Zlxwy/GraduationProject/README.md

- [Code\_MasterController](#code_mastercontroller)
- [Code\_SlaveController](#code_slavecontroller)
- [Code\_SomeTools](#code_sometools)
- [Code\_TestCode](#code_testcode)
- [Doc\_DesignData](#doc_designdata)
- [Model\_ChineseChess](#model_chinesechess)
- [PCB\_BaseBoard](#pcb_baseboard)

## Code_MasterController

上位机 RDK X5 的程序。

## Code_SlaveController

下位机 STM32F407ZGT6 的程序。

## Code_SomeTools

编写的一些辅助开发使用的小工具。

## Code_TestCode
一些测试代码，如程序功能验证、硬件完好性测试等。

## Doc_DesignData

设计资料、文档。

## Model_ChineseChess

中国象棋的 3D 模型

## PCB_BaseBoard

使用嘉立创 EDA 绘制的底板 PCB 文件。
