Zlxwy/GraduationProject/Doc_DesignData/004_通信协议.md

* [协议简介](#协议简介)
* [协议内容](#协议内容)
  * [步进电机基础行走请求](#步进电机基础行走请求)
  * [机械臂XY平面行走请求](#机械臂XY平面行走请求)
  * [竖轴位置请求](#竖轴位置请求)
  * [磁铁使能请求](#磁铁使能请求)
  * [机械臂标定完成应答](#机械臂标定完成应答)
  * [按键Click事件](#按键Click事件)

# 协议简介

1. 双帧头发送
    - (FrameHeader) 第1个字节固定为0x53
    - (FrameType) 第2个字节则根据请求帧、应答帧、事件帧的不同而不同
        - (RequestFrame) 请求帧：0xCA
        - (ResponseFrame) 应答帧：0x35
        - (EventFrame) 事件帧：0x96
2. (PayloadSize) 然后就是4个字节，表示数据长度，为大端字节序
3. (PayloadData) 然后就是主要数据部分，其长度为上一步中指定的长度
    - (CommandType) 数据部分的前2个字节用来表示指令类型
4. (CRC16) 最后就是2个字节的CRC16校验，也为大端字节序

# 协议内容

> 以下示例命令的CommandType和校验码都不准确

## ✔ 步进电机基础行走请求

```
描述：指定步进电机，以指定速度，行走指定步数
帧类型：请求帧，上至下
CommandType固定为0x00 0x00
```

| PayloadData 包含字段 | 字节偏移 | 长度(Byte) | 序列类型 | 说明 |
| --- | --- | --- | --- | --- |
| CommandType | 0 | 2 | uint16，大端序 | 固定为0x00 0x00 |
| MotorID | 2 | 1 | uint8，单字节 | 标识步进电机：<ul><li>0x00 - 肩关节电机</li><li>0x01 - 肘关节电机</li><li>0x02 - 竖轴电机</li></ul> |
| ActionType | 3 | 1 | uint8，单字节 | 动作类型：<ul><li>0x00 - 停止</li><li>0x01：旋转指定步数</li><li>0x02 - 持续旋转（Steps为-1则反转，Steps为1则正转）</li></ul> |
| Steps | 4 | 8 | int64，大端序 | 指定行走步数 |
| Speed | 12 | 4 | uint32，大端序 | 指定行走速度 |

| FrameHeader | FrameType | PayloadSize | CommandType | MotorID | ActionType | Steps | Speed | CRC16 |
| --- | --- | --- | --- | --- | --- | --- | --- | --- |
| 53 | CA | 00 00 00 10 | 00 00 | 00 | 01 | 00 00 00 00 00 00 00 C8 | 00 00 02 9A | xx xx |
| 帧头 | 帧类型：<br>请求帧 | 数据长度：<br>16字节 | 指令类型：<br>步进电机基础行走 | 电机ID：<br>0x00 | 动作类型：<br>旋转指定步数 | 步数：<br>0x00C8(200)步 | 速度：<br>0x029A(666)Hz | CRC16校验：<br>0x3687 |
| 53 | CA | 00 00 00 10 | 00 00 | 00 | 01 | 00 00 00 00 00 00 01 90 | 00 00 06 13 | xx xx |
| 帧头 | 帧类型：<br>请求帧 | 数据长度：<br>16字节 | 指令类型：<br>步进电机基础行走 | 电机ID：<br>0x00 | 动作类型：<br>旋转指定步数 | 步数：<br>0x0190(400)步 | 速度：<br>0x0613(1555)Hz | CRC16校验：<br>0xA85D |
| 53 | CA | 00 00 00 10 | 00 00 | 00 | 01 | FF FF FF FF FF FF FE 70 | 00 00 02 9A | xx xx |
| 帧头 | 帧类型：<br>请求帧 | 数据长度：<br>16字节 | 指令类型：<br>步进电机基础行走 | 电机ID：<br>0x00 | 动作类型：<br>旋转指定步数 | 步数：<br>0xFFFFFFFFFFFFFE70(-400)步 | 速度：<br>0x029A(666)Hz | CRC16校验：<br>0x5F75 |

## 机械臂XY平面行走请求

```
描述：控制机械臂在XY平面上行走到指定坐标点
帧类型：请求帧，上至下
CommandType固定为0x00 0x01
```

| PayloadData 包含字段 | 字节偏移 | 长度(Byte) | 序列类型 | 说明 |
| --- | --- | --- | --- | --- |
| CommandType | 0 | 2 | uint16，大端序 | 固定为0x00 0x01 |
| PixelCoordX | 2 | 4 | float，大端序 | 指定X轴坐标点，单位为像素 |
| PixelCoordY | 6 | 4 | float，大端序 | 指定Y轴坐标点，单位为像素 |
| Side | 10 | 1 | bool，单字节 | 机械臂关节向哪边拐：<ul><li>0x00 - 左拐</li><li>else - 右拐</li></ul> |

| FrameHeader | FrameType | PayloadSize | CommandType | PixelCoordX | PixelCoordY | Side | CRC16 |
| --- | --- | --- | --- | --- | --- | --- | --- |
| 53 | CA | 00 00 00 0B | 00 03 | 42 61 49 BA | 44 83 48 00 | 00 | 58 5F |
| 帧头 | 帧类型：<br>请求帧 | 数据长度：<br>11字节 | 指令类型：<br>机械臂X-Y平面行走 | X轴坐标点：<br>0x426149BA(56.322)像素 | Y轴坐标点：<br>0x44834800(1050.25)像素 | 左拐 | CRC16校验：<br>0x585F |
| 53 | CA | 00 00 00 0B | 00 03 | 3F 99 99 9A | 41 2E 3D 71 | 01 | 62 90 |
| 帧头 | 帧类型：<br>请求帧 | 数据长度：<br>11字节 | 指令类型：<br>机械臂X-Y平面行走 | X轴坐标点：<br>0x3F99999A(1.2)像素 | Y轴坐标点：<br>0x412E3D71(10.89)像素 | 右拐 | CRC16校验：<br>0x6290 |
| 53 | CA | 00 00 00 0B | 00 03 | 44 04 60 00 | 44 5E 33 33 | 61 | 6A 78 |
| 帧头 | 帧类型：<br>请求帧 | 数据长度：<br>11字节 | 指令类型：<br>机械臂X-Y平面行走 | X轴坐标点：<br>0x44046000(529.5)像素 | Y轴坐标点：<br>0x445E3333(888.8)像素 | 右拐 | CRC16校验：<br>0x6A78 |

## ✔ 竖轴复位请求

```
描述：控制机械臂Z轴复位到限位器处
帧类型：请求帧，上至下
CommandType固定为0x00 0x02
```

| PayloadData 包含字段 | 字节偏移 | 长度(Byte) | 序列类型 | 说明 |
| --- | --- | --- | --- | --- |
| CommandType | 0 | 2 | uint16，大端序 | 固定为0x00 0x02 |

| FrameHeader | FrameType | PayloadSize | CommandType | CRC16 |
| --- | --- | --- | --- | --- |

## ✔ 竖轴位置请求

```
描述：控制机械臂Z轴下降位置
帧类型：请求帧，上至下
CommandType固定为0x00 0x02
```

| PayloadData 包含字段 | 字节偏移 | 长度(Byte) | 序列类型 | 说明 |
| --- | --- | --- | --- | --- |
| CommandType | 0 | 2 | uint16，大端序 | 固定为0x00 0x02 |
| PositionZ | 2 | 4 | float，大端序 | 指定Z轴下降级数，范围0~100 |

| FrameHeader | FrameType | PayloadSize | CommandType | PositionZ | CRC16 |
| --- | --- | --- | --- | --- | --- |

## ✔ 设置磁铁状态

```
描述：设置磁铁状态
帧类型：请求帧，上至下
CommandType固定为0x00 0x05
```

| PayloadData 包含字段 | 字节偏移 | 长度(Byte) | 序列类型 | 说明 |
| --- | --- | --- | --- | --- |
| CommandType | 0 | 2 | uint16，大端序 | 固定为0x00 0x05 |
| MagnetStatus | 2 | 1 | uint8，单字节 | 磁铁状态：<ul><li>0x00 - 禁用</li><li>0x01 - 正向电压使能</li><li>0x02 - 反向电压使能</li></ul> |

> 示例指令：53 CA 00 00 00 03 00 03 00 6D B3
> 示例指令：53 CA 00 00 00 03 00 03 01 7D 92

## 机械臂标定完成应答

```
描述：在进入机械臂标定模式后，操作完成应答
帧类型：应答帧，上至下
CommandType固定为0x00 0x03
```

| PayloadData 包含字段 | 字节偏移 | 长度(Byte) | 序列类型 | 说明 |
| --- | --- | --- | --- | --- |
| CommandType | 0 | 2 | uint16，大端序 | 固定为0x00 0x03 |

| FrameHeader | FrameType | PayloadSize | CommandType | CRC16 |
| --- | --- | --- | --- | --- |
| 53 | 35 | 00 00 00 02 | 00 02 | 5C 27 |
| 帧头 | 帧类型：<br>应答帧 | 数据长度：<br>2字节 | 指令类型：<br>机械臂标定完成应答 | CRC16校验：<br>0x5C27 |

## ✔ 按键点击事件

```
描述：按键点击事件
帧类型：事件帧，下至上
CommandType固定为0x00 0x04
```

| PayloadData 包含字段 | 字节偏移 | 长度(Byte) | 序列类型 | 说明 |
| --- | --- | --- | --- | --- |
| CommandType | 0 | 2 | uint16，大端序 | 固定为0x00 0x04 |
| KeyIndex | 2 | 2 | uint16，大端序 | 按键索引：<ul><li>0x0000(Key0) - 显示/隐藏棋盘锚定框</li><li>0x0001(Key1) - 进入机械臂标定模式</li><li>0x0002(Key2) - 进入整理模式</li><li>0x0003(Key3) - 用户落子完成</li></ul> |
| KeyMotion | 4 | 1 | uint8_t | 按键动作：<ul><li>0x00 - 按键按下(Pressed)</li><li>0x01 - 按键释放(Released)</li></ul> |

| FrameHeader | FrameType | PayloadSize | CommandType | KeyIndex | KeyMotion | CRC16 |
| --- | --- | --- | --- | --- | --- | -- |
| 53 | 96 | 00 00 00 04 | 00 01 | 00 00 | 00 | BE 88 |
| 帧头 | 帧类型：<br>事件帧 | 数据长度：<br>4字节 | 指令类型：<br>按键点击事件 | 按键索引：<br>0x0000(Key0) - 显示/隐藏棋盘锚定框 | 按键动作：<br>按键按下 | CRC16校验：<br>0xBE88 |
| 53 | 96 | 00 00 00 04 | 00 01 | 00 01 | 00 | AE A9 |
| 帧头 | 帧类型：<br>事件帧 | 数据长度：<br>4字节 | 指令类型：<br>按键点击事件 | 按键索引：<br>0x0001(Key1) - 进入机械臂标定模式 | 按键动作：<br>按键按下 | CRC16校验：<br>0xAEA9 |
| 53 | 96 | 00 00 00 04 | 00 01 | 00 02 | 01 | 9E CA |
| 帧头 | 帧类型：<br>事件帧 | 数据长度：<br>4字节 | 指令类型：<br>按键点击事件 | 按键索引：<br>0x0002(Key2) - 进入整理模式 | 按键动作：<br>按键释放 | CRC16校验：<br>0x9ECA |
