Zlxwy/GraduationProject/Doc_DesignData/002_制作器件.md

[TOC]

## PCB物料

| 平台 | 店铺 | 物件 | 数量 | 单价(元) | 总付款(元) | 链接 |
| --- | --- | --- | --- | --- | --- | --- |
| 淘宝 | 科讯达数码专配店 | 12V10A电源适配器 | 1 | 32.5 | 32.5 | https://item.taobao.com/item.htm?id=708135618778&skuId=5980676298476 |
| 淘宝 | telesky旗舰店 | LM2596S\_5V\_稳压模块 | 2 | 4.24 | 8.48 | https://detail.tmall.com/item.htm?id=41307963557&skuId=5352660439882 |
| 淘宝 | 深圳市优信电子科技有限公司 | XH2.54\_10P\_直针插座(10个装) | 1 | 1.1 | 1.1 | https://item.taobao.com/item.htm?id=522555535449&skuId=5777387544677 |
| 淘宝 | 深圳市优信电子科技有限公司 | XH2.54\_10P\_插头胶壳(10个装) | 1 | 0.55 | 0.55 | https://item.taobao.com/item.htm?id=522555535449&skuId=5777387544705 |
| 淘宝 | 深圳市优信电子科技有限公司 | XH2.54\_4P\_直针插座(10个装) | 1 | 0.44 | 0.44 | https://item.taobao.com/item.htm?id=522555535449&skuId=5777387544671 |
| 淘宝 | 深圳市优信电子科技有限公司 | XH2.54\_4P\_插头胶壳(10个装) | 1 | 0.22 | 0.22 | https://item.taobao.com/item.htm?id=522555535449&skuId=5777387544699 |
| 淘宝 | 深圳市优信电子科技有限公司 | XH2.54\_3P\_直针插座(10个装) | 1 | 0.33 | 0.33 | https://item.taobao.com/item.htm?id=522555535449&skuId=5777387544670 |
| 淘宝 | 深圳市优信电子科技有限公司 | XH2.54\_3P\_插头胶壳(10个装) | 1 | 0.16 | 0.16 | https://item.taobao.com/item.htm?id=522555535449&skuId=5777387544698 |
| 淘宝 | 深圳市优信电子科技有限公司 | XH2.54\_2P\_直针插座(10个装) | 1 | 0.22 | 0.22 | https://item.taobao.com/item.htm?id=522555535449&skuId=5777387544669 |
| 淘宝 | 深圳市优信电子科技有限公司 | XH2.54\_2P\_插头胶壳(10个装) | 1 | 0.11 | 0.11 | https://item.taobao.com/item.htm?id=522555535449&skuId=5777387544697 |
| 淘宝 | 深圳市优信电子科技有限公司 | π122U31电平隔离芯片 | 1 | 0.8 | 0.8 | https://item.taobao.com/item.htm?id=713359542163 |
| 淘宝 | 深圳市优信电子科技有限公司 | UWM-817C-S光耦合器芯片 | 4 | 0.13 | 0.52 | https://item.taobao.com/item.htm?id=654107995926 |
| 淘宝 | 深圳市优信电子科技有限公司 | M7通用二极管(10个装) | 1 | 0.88 | 0.88 | https://item.taobao.com/item.htm?id=545440281632 |
| 淘宝 | 深圳市优信电子科技有限公司 | 0805贴片电阻10kΩ(50个装) | 1 | 1.1 | 1.1 | https://item.taobao.com/item.htm?id=526088038633&skuId=5870421994599 |
| 淘宝 | 深圳市优信电子科技有限公司 | 0805贴片电阻4.7kΩ(50个装) | 1 | 1.1 | 1.1 | https://item.taobao.com/item.htm?id=526088038633&skuId=5870421994575 |
| 淘宝 | 深圳市优信电子科技有限公司 | 0805贴片LED黄色(10个装) | 1 | 2.2 | 2.2 | https://item.taobao.com/item.htm?id=570459797098&skuId=5935337974485 |
| 淘宝 | 深圳市优信电子科技有限公司 | 0805贴片LED翠绿色(10个装) | 1 | 2.75 | 2.75 | https://item.taobao.com/item.htm?id=570459797098&skuId=5935337974486 |
| 淘宝 | 深圳市优信电子科技有限公司 | 0805贴片LED蓝色(10个装) | 1 | 1.98 | 1.98 | https://item.taobao.com/item.htm?id=570459797098&skuId=5935337974484 |
| 淘宝 | 深圳市优信电子科技有限公司 | SS12D06G5\_3脚2档\_弯插拨动开关(5个装) | 1 | 2.64 | 2.64 | https://item.taobao.com/item.htm?id=568771505825&skuId=6130758858580 |
| 淘宝 | 深圳市优信电子科技有限公司 | DC005\_DC5525\_耐高温插座 | 1 | 0.2 | 0.2 | https://item.taobao.com/item.htm?id=556796729366&skuId=6130630902911 |
| 淘宝 | 深圳市宏宇通电子商行 | 2EDGK型接头\_2P开口式弯针插座+2P插头 | 1 | 0.24 | 0.24 | https://item.taobao.com/item.htm?id=589242587984&skuId=4021244136536 |

## 象棋制作物料

| 平台 | 店铺 | 物件 | 数量 | 单价(元) | 总付款(元) | 链接 |
| --- | --- | --- | --- | --- | --- | --- |
| 嘉立创 | 嘉立创3D打印 | 棋子模型\_材质LEDO白色\_粗磨(50件) | 1 | 96.29 | 96.29 | https://www.jlc-3dp.cn/placeOrder?spm=3D.Homepage.icon1.1001 |
| 淘宝 | 中钢金属物资 | 圆柱形铁饼\_直径18mm\_高6mm(64件) | 1 | 100 | 100 | https://shop596005788.taobao.com/ |
| 闲鱼 | 乐逸印务 | 棋子贴纸\_整张A3纸打印 | 1 | 35 | 35 | https://www.goofish.com/item?id=996490925570 |
| 淘宝 | 星星舟旗舰店 | 大号中国象棋棋盘 | 1 | 22.8 | 22.8 | https://detail.tmall.com/item.htm?id=853560984174&skuId=6202772638395 |

## 控制器

| 平台 | 店铺 | 物件 | 数量 | 单价(元) | 总付款(元) | 链接 |
| --- | --- | --- | --- | --- | --- | --- |
| 淘宝 | 轮趣科技 | Linux板卡\_RDKX5 | 1 | 0 | 0 | https://item.taobao.com/item.htm?id=676436236906&sku_properties=1627207%3A35383862860 |
| 淘宝 | 桔恩迪电子 | STM32F407ZGT6核心板 | 1 | 72.99 | 72.99 | https://item.taobao.com/item.htm?id=767987284614&skuId=5296354469371 |
| 淘宝 | 桔恩迪电子 | 3.2寸TFT显示屏 | 1 | 79.99 | 79.99 | https://item.taobao.com/item.htm?id=811245556140&skuId=5674466479002 |

## 运动

| 平台 | 店铺 | 物件 | 数量 | 单价(元) | 总付款(元) | 链接 |
| --- | --- | --- | --- | --- | --- | --- |
| 淘宝 | 亿星科技步进伺服控制系统厂家 | 42步进电机 | 2 | 24 | 48 | https://item.taobao.com/item.htm?id=45176939892&skuId=4820009917609 |
| 淘宝 | 亿星科技步进伺服控制系统厂家 | 28步进电机 | 1 | 40 | 40 | https://item.taobao.com/item.htm?id=770017789135&skuId=5478339413663 |
| 淘宝 | 亿星科技步进伺服控制系统厂家 | 步进电机驱动器TB6600 | 3 | 30 | 90 | https://item.taobao.com/item.htm?id=45257012832&skuId=4473671716068 |
| 淘宝 | 风顺散热风扇 | 12V散热扇 | 1 | 5.5 | 5.5 | https://item.taobao.com/item.htm?id=582585891952&skuId=3903184540519 |
| 淘宝 | 恒运电磁铁制造商 | 12V电磁铁 | 1 | 6.69 | 6.69 | https://item.taobao.com/item.htm?id=639903956109&skuId=4601479117245 |
| 淘宝 | 深圳权芯发电子网店 一站配套 | L298N芯片+H型散热片 | 1 | 3.6 | 3.6 | https://item.taobao.com/item.htm?id=650714392966&skuId=4713871520670 |
| 淘宝 | 东菱工控 | U型槽型光电开关 | 1 | 7 | 7 | https://item.taobao.com/item.htm?id=626384709746&skuId=4934038281099 |

## 视觉

| 平台 | 店铺 | 物件 | 数量 | 单价(元) | 总付款(元) | 链接 |
| --- | --- | --- | --- | --- | --- | --- |
| 淘宝 | 杰锐微通旗舰店 | USB摄像头\_1080P | 1 | 128 | 128 | https://detail.tmall.com/item.htm?id=658336439677&skuId=4747876349104 |
| 淘宝 | 杰锐微通旗舰店 | USB摄像头\_适配无畸变3.25mm焦距100度镜头 | 1 | 58 | 58 | https://detail.tmall.com/item.htm?id=667551614995&skuId=4984718463985 |

## 接线

| 平台 | 店铺 | 物件 | 数量 | 单价(元) | 总付款(元) | 链接 |
| --- | --- | --- | --- | --- | --- | --- |
| 淘宝 | 上海凯豪电线电缆 | 0.3平方毫米线材\_100m长度\_黑色 | 1 | 25.74 | 25.74 | https://item.taobao.com/item.htm?id=575478995725&skuId=3775114793012 |
| 淘宝 | elecall旗舰店 | E2508管型端子\_黑色(100个装) | 1 | 3.42 | 3.42 | https://detail.tmall.com/item.htm?id=523300941522&skuId=5145209079969 |
| 淘宝 | elecall旗舰店 | E2508管型端子\_红色(100个装) | 1 | 3.42 | 3.42 | https://detail.tmall.com/item.htm?id=523300941522&skuId=4931023561692 |
| 淘宝 | 晶凝峰芯达专卖店 | XH2.54\_插接簧片(100个装) | 2 | 3.53 | 7.06 | https://detail.tmall.com/item.htm?id=41586800103&skuId=4973828213488 |

## 通信

| 平台 | 店铺 | 物件 | 数量 | 单价(元) | 总付款(元) | 链接 |
| --- | --- | --- | --- | --- | --- | --- |
| 淘宝 | 橘易 | CH343\_USB串口模块 | 1 | 14.9 | 14.9 | https://item.taobao.com/item.htm?id=781272048581&skuId=5507569043535 |
| 淘宝 | 绿联数码旗舰店 | USB2.0延长线1m | 2 | 14.9 | 29.8 | https://detail.tmall.com/item.htm?id=38926165525&skuId=6186711490290 |
| 淘宝 | orico旗舰店 | USB一拖三拓展坞 | 1 | 29.9 | 29.9 | https://detail.tmall.com/item.htm?id=658654834040&skuId=5143148725455 |

## 框架

| 平台 | 店铺 | 物件 | 数量 | 单价(元) | 总付款(元) | 链接 |
| --- | --- | --- | --- | --- | --- | --- |
| 淘宝 | 深圳探木坊铝业 | 铝型材\_欧标2020L-1.5\_长度304mm\_1件 | 1 | 3.8 | 3.8 | https://item.taobao.com/item.htm?id=707146227727&skuId=5138065850308 |
| 淘宝 | 深圳探木坊铝业 | 铝型材\_欧标2020L-1.5\_长度315mm\_2件 | 1 | 7.87 | 7.87 | https://item.taobao.com/item.htm?id=707146227727&skuId=5138065850308 |
| 淘宝 | 深圳探木坊铝业 | 铝型材\_欧标2020L-1.5\_长度264mm\_2件 | 1 | 6.6 | 6.6 | https://item.taobao.com/item.htm?id=707146227727&skuId=5138065850308 |
| 淘宝 | 深圳探木坊铝业 | 铝型材\_欧标2020L-1.5\_长度79mm\_1件 | 1 | 0.99 | 0.99 | https://item.taobao.com/item.htm?id=707146227727&skuId=5138065850308 |
| 淘宝 | 深圳探木坊铝业 | 铝型材\_欧标2020L-1.5\_长度56mm\_2件 | 1 | 1.4 | 1.4 | https://item.taobao.com/item.htm?id=707146227727&skuId=5138065850308 |
| 淘宝 | 深圳探木坊铝业 | 铝型材\_欧标2020L-1.5\_长度132mm\_1件 | 1 | 1.65 | 1.65 | https://item.taobao.com/item.htm?id=707146227727&skuId=5138065850308 |
| 淘宝 | 深圳探木坊铝业 | 铝型材\_欧标2020L-1.5\_长度99mm\_2件 | 1 | 2.47 | 2.47 | https://item.taobao.com/item.htm?id=707146227727&skuId=5138065850308 |
| 淘宝 | 深圳探木坊铝业 | 铝型材\_欧标2020L-1.5\_长度100mm\_2件 | 1 | 2.5 | 2.5 | https://item.taobao.com/item.htm?id=707146227727&skuId=5138065850308 |
| 淘宝 | 深圳探木坊铝业 | 铝型材\_欧标2020L-1.5\_长度186mm\_1件 | 1 | 2.32 | 2.32 | https://item.taobao.com/item.htm?id=707146227727&skuId=5138065850308 |
| 淘宝 | 深圳探木坊铝业 | 铝型材\_欧标2020L-1.5\_长度450mm\_2件 | 1 | 11.25 | 11.25 | https://item.taobao.com/item.htm?id=707146227727&skuId=5138065850308 |
| 淘宝 | 深圳探木坊铝业 | 铝型材紧固件\_欧标2020L-1.5\_直角角码 | 28 | 0.9 | 25.2 | https://item.taobao.com/item.htm?id=687965688085&skuId=4907036397671 |
| 淘宝 | 深圳探木坊铝业 | 铝型材紧固件\_欧标2020L-1.5\_转向角件 | 3 | 1.56 | 4.68 | https://item.taobao.com/item.htm?id=694506337343&skuId=4932711441831 |
| 闲鱼 | 用户AdoRobot | 三轴平面机械臂3D打印模型 | 1 | 600 | 600 | https://www.goofish.com/personal?userId=696934590 |

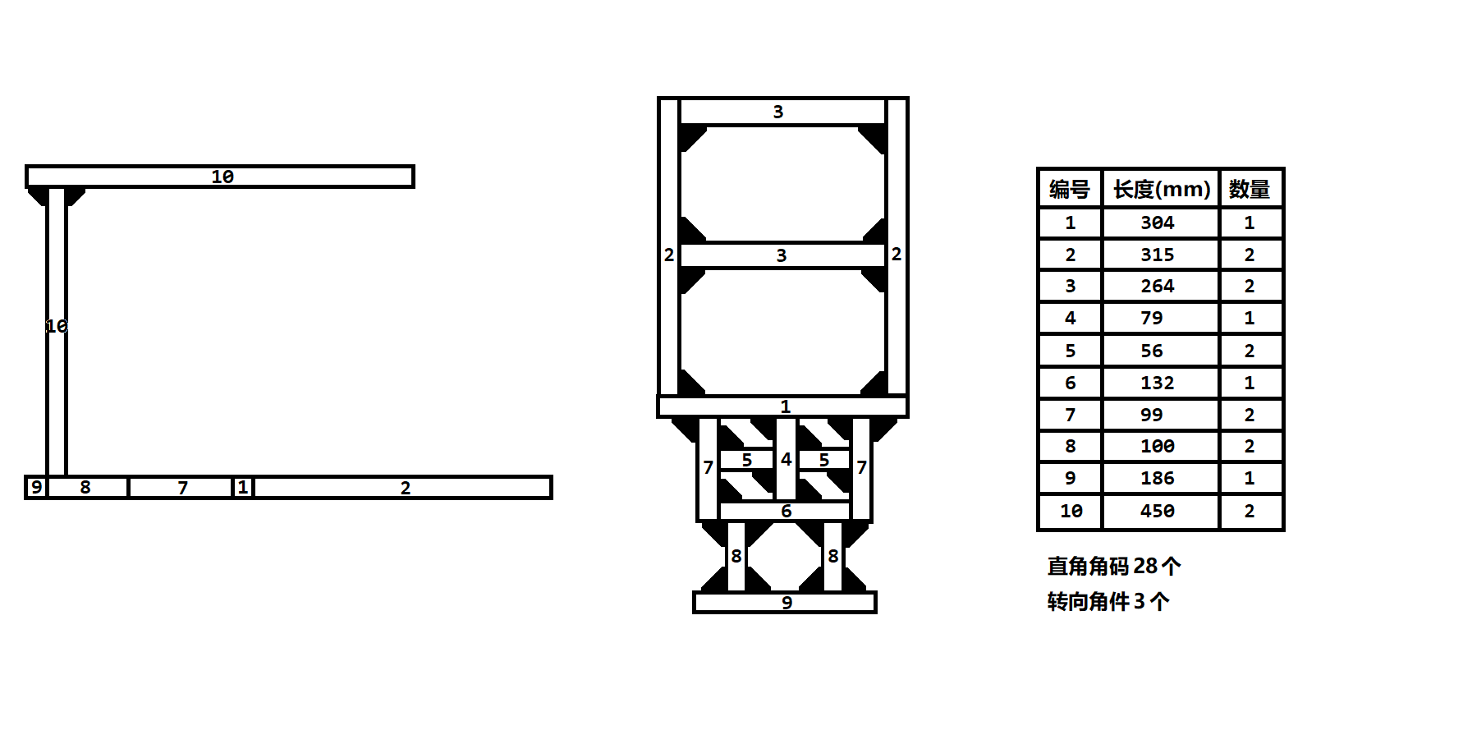
[picture p1: Doc_DesignData/.002_制作器件_assets/铝型材框架搭建图纸.png]
铝型材框架搭建图纸


## 灯源

| 平台 | 店铺 | 物件 | 数量 | 单价(元) | 总付款(元) | 链接 |
| --- | --- | --- | --- | --- | --- | --- |
| 淘宝 | 佳为照明旗舰店 | 12V灯带\_带铝合金外壳和奶白色灯罩\_暖白色\_灯带长20cm\_线长2m | 1 | 12 | 12 | https://detail.tmall.com/item.htm?id=714886023769&skuId=5169944318738 |
