Zlxwy/GraduationProject/Doc_DesignData/001_参考资料.md

## 一、基础层工具官方网站
[Ultralytics - YOLO](https://docs.ultralytics.com/quickstart/)

## 二、本科毕设的一个作品
[Bilibili - 中国象棋机器人演示视频-本科毕设](https://www.bilibili.com/video/BV1em42157BR)
[GitHub - ChineseChess](https://github.com/jfgfdhjhj/Chinese_chess_sliding_robot)

## 三、研究生电赛的一个作品
[Bilibili - 2022研电赛 基于EAIDK-610的中国象棋机器人对弈系统 演示视频](https://www.bilibili.com/video/BV1gt4y1u7NA)

[极术社区 -- 基于EAIDK-610的中国象棋机器人对弈系统](https://aijishu.com/a/1060000000361674)

[GitHub - ElephantFish](https://github.com/STM32xxx/Chinese-chess-robot-upper-computer?tab=readme-ov-file)

[GitHub - 原版ElephantFish(一个只有124行的中国象棋引擎)](https://github.com/bupticybee/elephantfish)

[Thingiverse - Desktop SCARA robot](https://www.thingiverse.com/thing:2339480/files)

## 四、写字机机械臂博主
[Bilibili - 3轴迷你SCRRA写字机](https://www.bilibili.com/video/BV1n2rjBnEsk)

[]()
