Zlxwy/GraduationProject/PCB_BaseBoard/版本说明.txt

v1
初版

v2
加了很多功能

v3
给π122U31连接上位机的一端加了两个10kΩ上拉电阻，还没实际测试过，不知道有没有问题。
