Zlxwy/GraduationProject/Code_SomeTools/WinFormsTemplate/如何使用WinForms模板.txt

用VSCode之类编辑器打开，搜索目录下所有的"WinFormsTemplate"字眼，替换为自己所需的项目名称

将所有带有"WinFormsTemplate"字眼文件名的文件，更改为自己所需的项目名称
