Zlxwy/GraduationProject/Code_TestCode/向量分解/figures/fig1_basic_concept.png

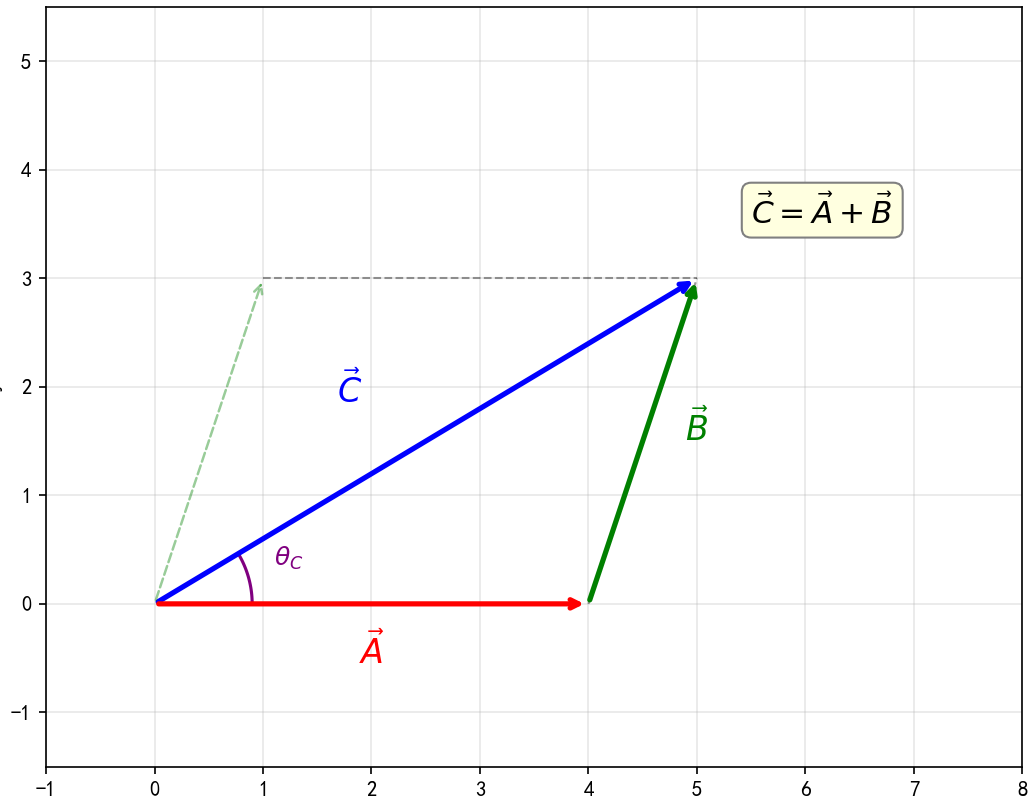
Code_TestCode/向量分解/figures/fig1_basic_concept.png
