Zlxwy/GraduationProject/Code_TestCode/向量分解/figures/fig6_special_cases.png

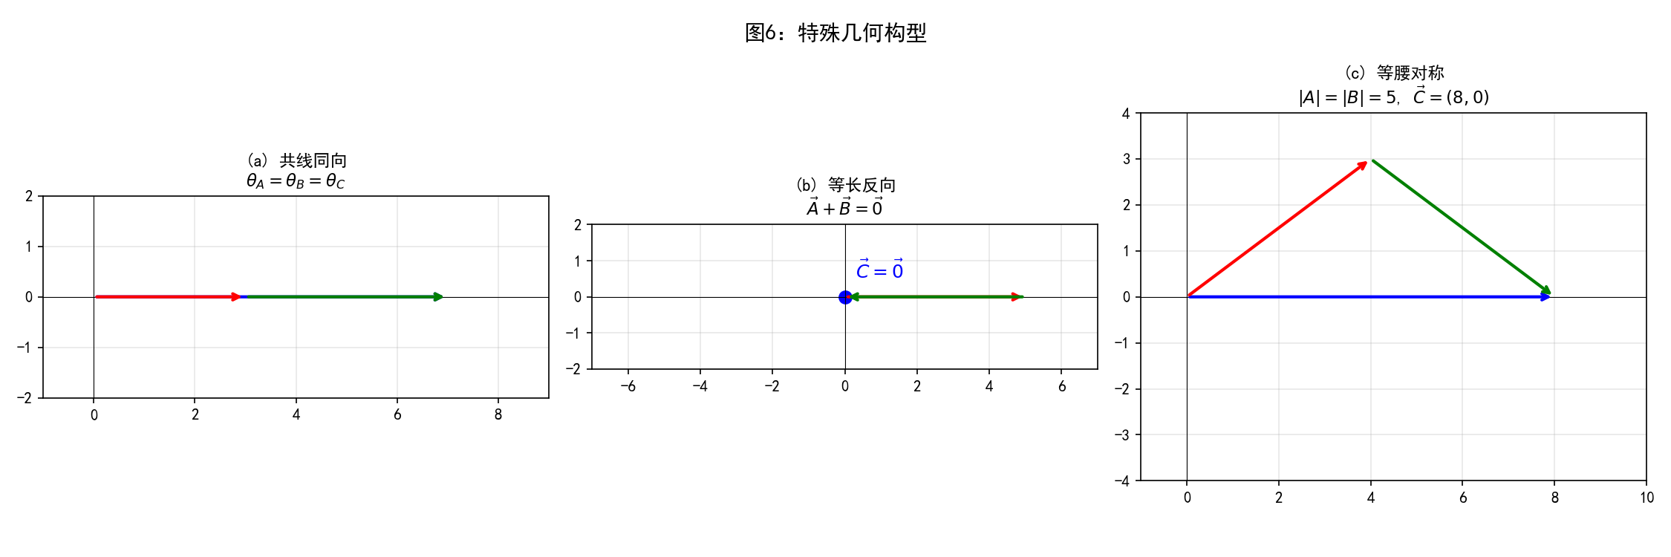
Code_TestCode/向量分解/figures/fig6_special_cases.png
