Zlxwy/GraduationProject/Doc_DesignData/.006_坐标系_assets/机械臂坐标系.png

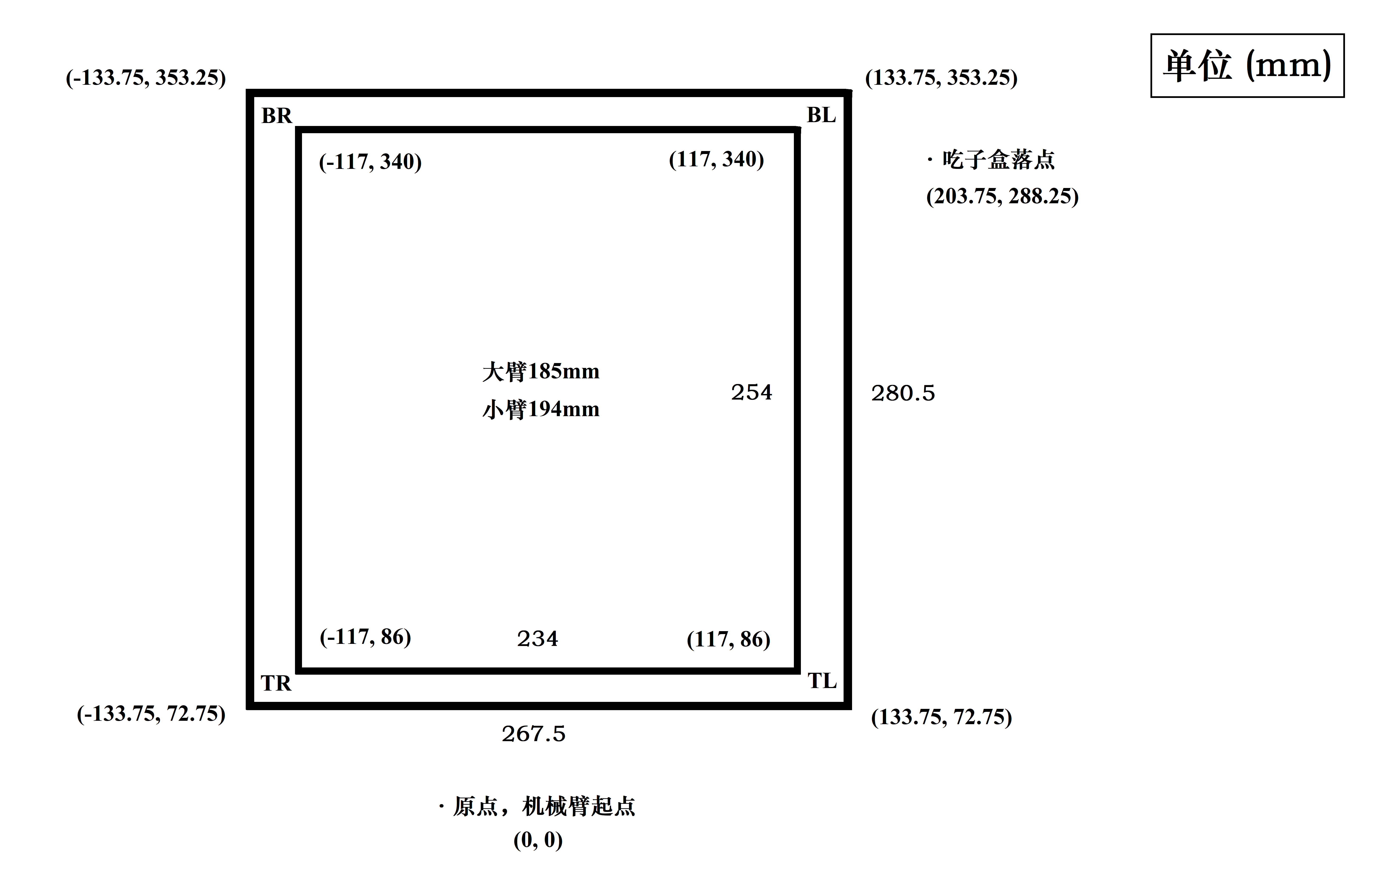
Doc_DesignData/.006_坐标系_assets/机械臂坐标系.png
