Zlxwy/GraduationProject/Model_ChineseChess/棋子贴纸.jpg

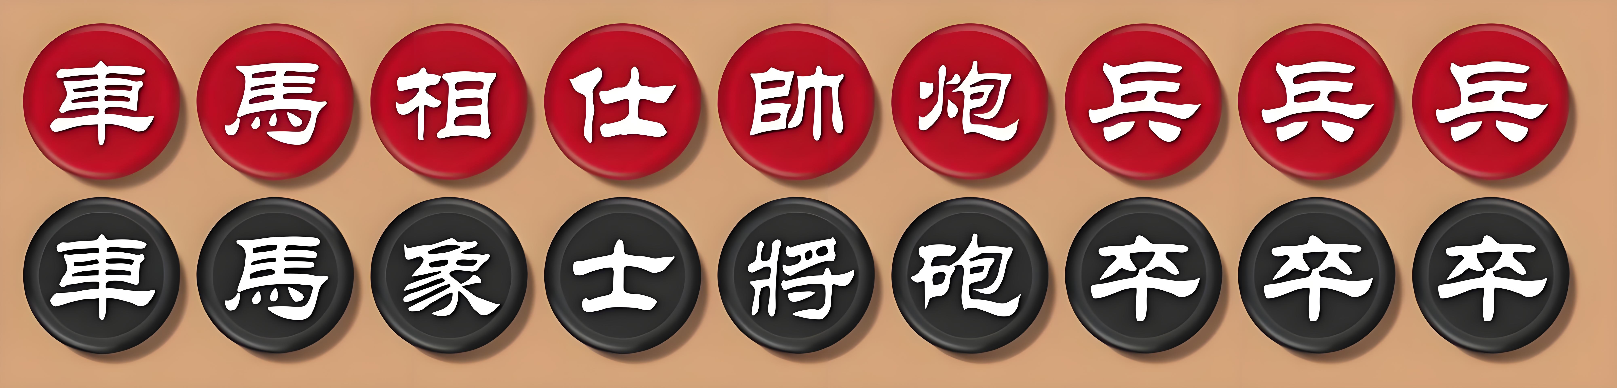
Model_ChineseChess/棋子贴纸.jpg
