Zlxwy/GraduationProject/Model_ChineseChess/棋子贴纸_抠图中.jpg

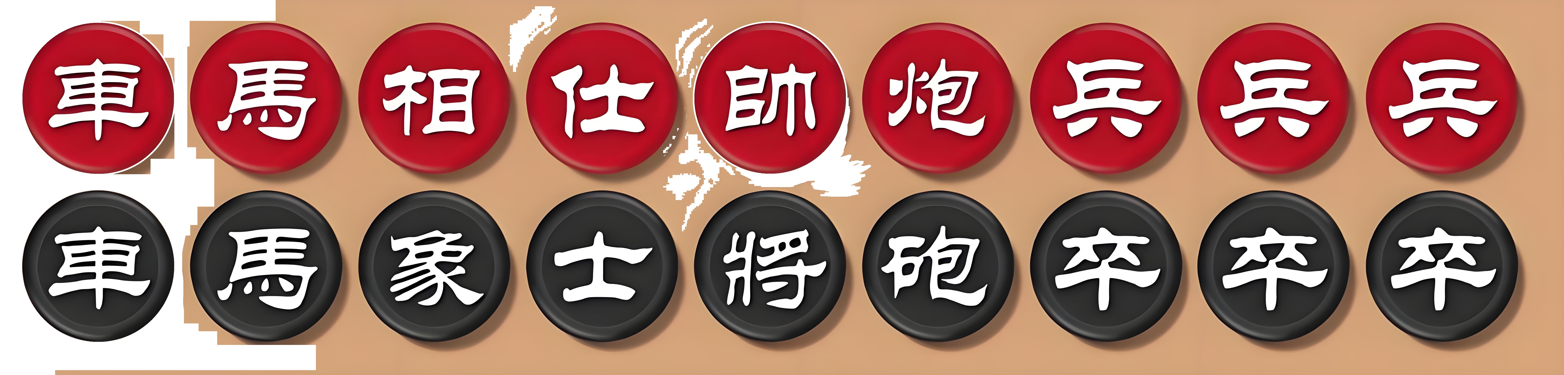
Model_ChineseChess/棋子贴纸_抠图中.jpg
