Zlxwy/GraduationProject/Model_ChineseChess/棋子模型.SLDPRT

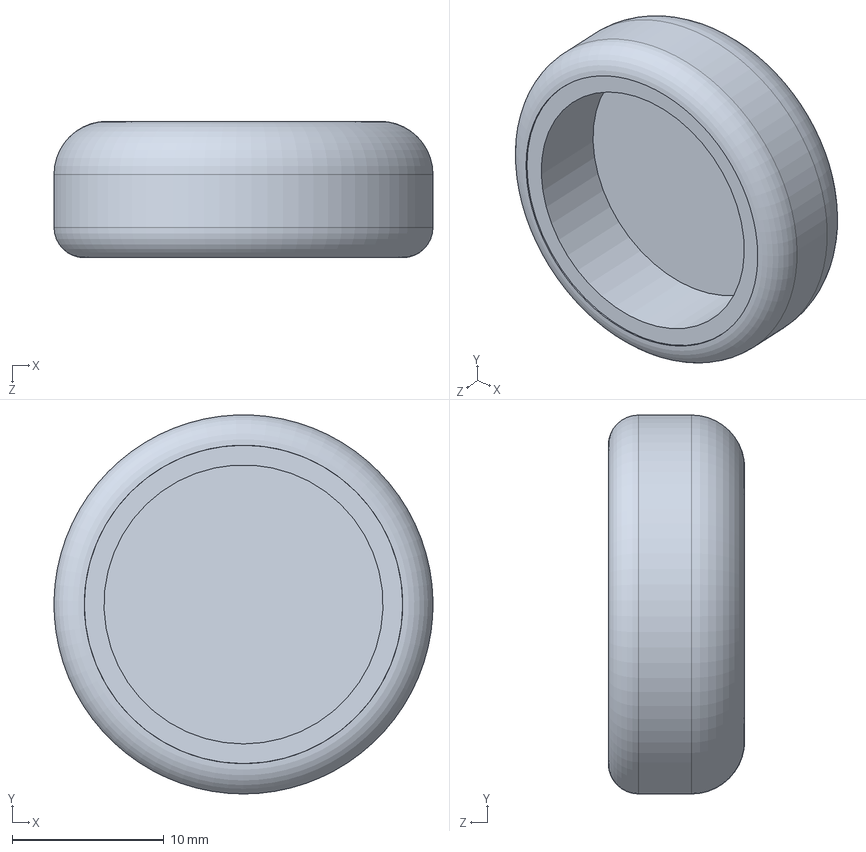
[picture p12: CAD file, 2026-03-29]
Model_ChineseChess/棋子模型.SLDPRT
25.0 x 25.0 x 9.00 mm
