Zlxwy/GraduationProject/Code_TestCode/STM32测试程序/Test-UartDmaQueueTx/工程说明.txt

串口使用DMA进行发送，通过队列，不再是直接发送，是压入队列后，在一个线程中循环检测待发送队列进行发送。
