Zlxwy/GraduationProject/Code_TestCode/STM32测试程序/Test-SimplePWM/工程说明.txt

TIM10和TIM11是168MHz的时钟
TIM13和TIM14是84MHz的时钟

步进电机驱动测试。
