Zlxwy/GraduationProject/Code_TestCode/STM32测试程序/Test-ADCwithDMA/工程说明.txt

ADC配合DMA，在ADC转换完后，DMA自动将结果转运到一个变量中，如果需要获取电压值，只需要读取变量就行，CPU其他啥事不用干，甚至不需要ADC转换完成中断。
