Zlxwy/GraduationProject/Code_TestCode/中国象棋棋子识别_MobileNetV3/模型训练/model_training/模型文件说明.txt

chess_mobilenetv3.pt_backup1
2026.4.11，这个是第一次训练，每个类别图片只有100多张

chess_mobilenetv3.pt_backup2
2026.4.18.20:26，这个是第二次训练，每个类别图片增加到了336张

chess_mobilenetv3.pt_backup3
2026.4.18.22:24，这个是第三次训练，把学习率LR改为1e-4，权重衰减WEIGHT_DECAY改为1e-5，20轮无改善早停，训练1000多轮
