Zlxwy/GraduationProject/Code_TestCode/中国象棋棋子识别_YOLO/runs/detect/train/results.csv

epoch | time | train/box_loss | train/cls_loss | train/dfl_loss | metrics/precision(B) | metrics/recall(B) | metrics/mAP50(B) | metrics/mAP50-95(B) | val/box_loss | val/cls_loss | val/dfl_loss | lr/pg0 | lr/pg1 | lr/pg2
1 | 15.1241 | 1.30318 | 4.74738 | 1.20847 | 0 | 0 | 0 | 0 | 1.03729 | 4.85337 | 1.03536 | 3.336e-05 | 3.336e-05 | 3.336e-05
2 | 31.6425 | 1.1231 | 4.47449 | 1.06592 | 0 | 0 | 0 | 0 | 1.05634 | 4.57889 | 0.9297 | 7.15644e-05 | 7.15644e-05 | 7.15644e-05
3 | 47.9013 | 0.86965 | 4.16033 | 0.93465 | 0 | 0 | 0 | 0 | 0.97247 | 4.48535 | 0.89022 | 0.000108998 | 0.000108998 | 0.000108998
4 | 64.1464 | 0.80913 | 3.93105 | 0.91345 | 0 | 0 | 0 | 0 | 1.03846 | 4.4431 | 0.89046 | 0.000145661 | 0.000145661 | 0.000145661
5 | 80.3075 | 0.78793 | 3.67998 | 0.89476 | 0.05612 | 0.27527 | 0.05832 | 0.0451 | 1.03927 | 4.18498 | 0.88048 | 0.000181554 | 0.000181554 | 0.000181554
6 | 93.7236 | 0.76021 | 3.37588 | 0.87467 | 0.05095 | 0.58486 | 0.07662 | 0.05948 | 0.87304 | 3.87538 | 0.84204 | 0.000216676 | 0.000216676 | 0.000216676
7 | 107.068 | 0.76181 | 3.18025 | 0.8894 | 0.05892 | 0.75111 | 0.0921 | 0.0736 | 0.87836 | 3.51033 | 0.84953 | 0.000251027 | 0.000251027 | 0.000251027
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
