Zlxwy/GraduationProject/Code_TestCode/手写数字识别_YOLO/runs/detect/train/results.csv

epoch | time | train/box_loss | train/cls_loss | train/dfl_loss | metrics/precision(B) | metrics/recall(B) | metrics/mAP50(B) | metrics/mAP50-95(B) | val/box_loss | val/cls_loss | val/dfl_loss | lr/pg0 | lr/pg1 | lr/pg2
1 | 2.49942 | 1.59055 | 4.6947 | 0.95159 | 0 | 0 | 0 | 0 | 0 | 0 | 0 | 1.428e-05 | 1.428e-05 | 1.428e-05
2 | 5.23753 | 1.5858 | 4.68468 | 0.95837 | 0 | 0 | 0 | 0 | 0 | 0 | 0 | 3.56293e-05 | 3.56293e-05 | 3.56293e-05
3 | 7.89148 | 1.40114 | 4.67929 | 0.91921 | 0 | 0 | 0 | 0 | 0 | 0 | 0 | 5.68938e-05 | 5.68938e-05 | 5.68938e-05
4 | 10.6748 | 1.45185 | 4.63606 | 0.92249 | 0 | 0 | 0 | 0 | 0 | 0 | 0 | 7.80735e-05 | 7.80735e-05 | 7.80735e-05
5 | 13.0869 | 1.24721 | 4.65193 | 0.88659 | 0 | 0 | 0 | 0 | 0 | 0 | 0 | 9.91683e-05 | 9.91683e-05 | 9.91683e-05
6 | 15.5935 | 1.40256 | 4.61446 | 0.92687 | 0 | 0 | 0 | 0 | 0 | 0 | 0 | 0.000120178 | 0.000120178 | 0.000120178
7 | 17.4871 | 1.45851 | 4.62284 | 0.93453 | 0 | 0 | 0 | 0 | 0 | 0 | 0 | 0.000141104 | 0.000141104 | 0.000141104
8 | 19.1919 | 1.22268 | 4.55255 | 0.87948 | 0 | 0 | 0 | 0 | 0 | 0 | 0 | 0.000161944 | 0.000161944 | 0.000161944
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
