Zlxwy/GraduationProject/Code_TestCode/三角函数/plot_pic/plot_arccos.png

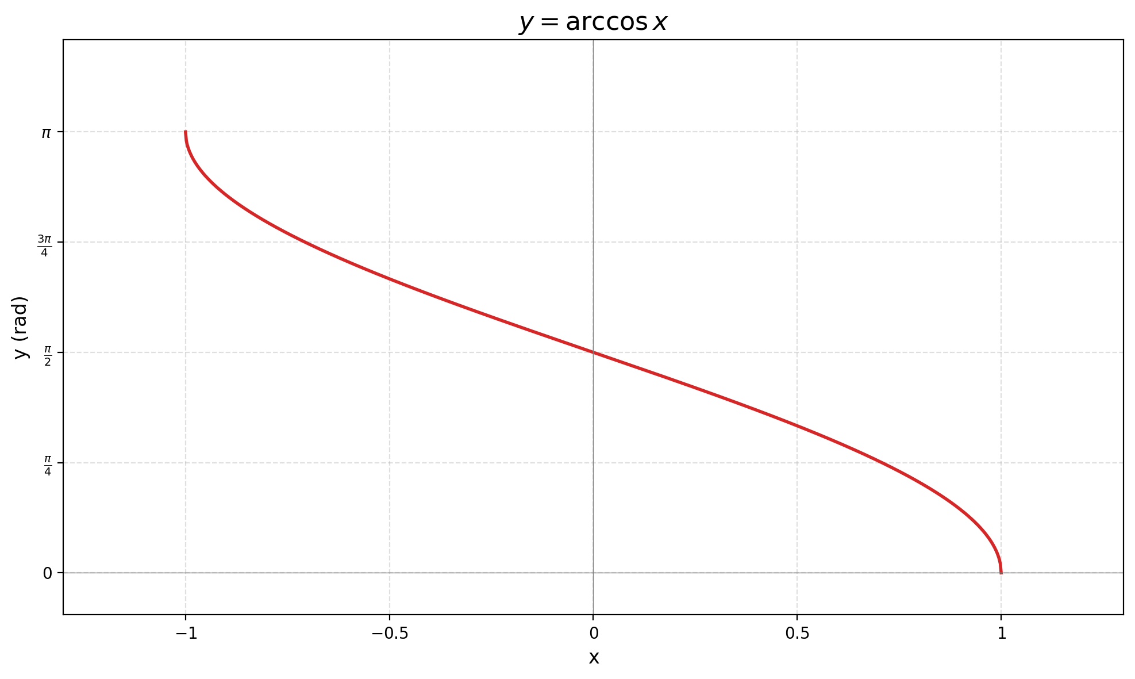
Code_TestCode/三角函数/plot_pic/plot_arccos.png
