Zlxwy/GraduationProject/Code_TestCode/向量分解/figures/fig2_law_of_cosines.png

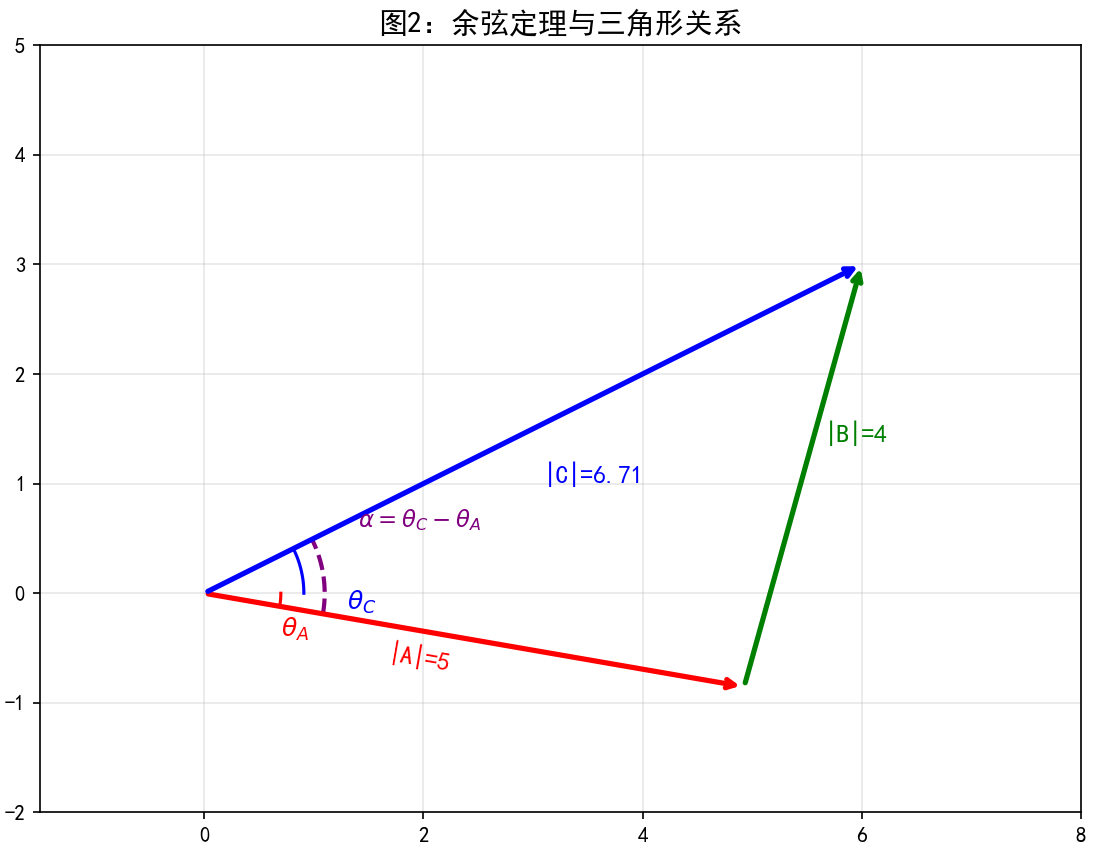
Code_TestCode/向量分解/figures/fig2_law_of_cosines.png
