Zlxwy/GraduationProject/Code_TestCode/向量分解/figures/fig3_two_solutions.png

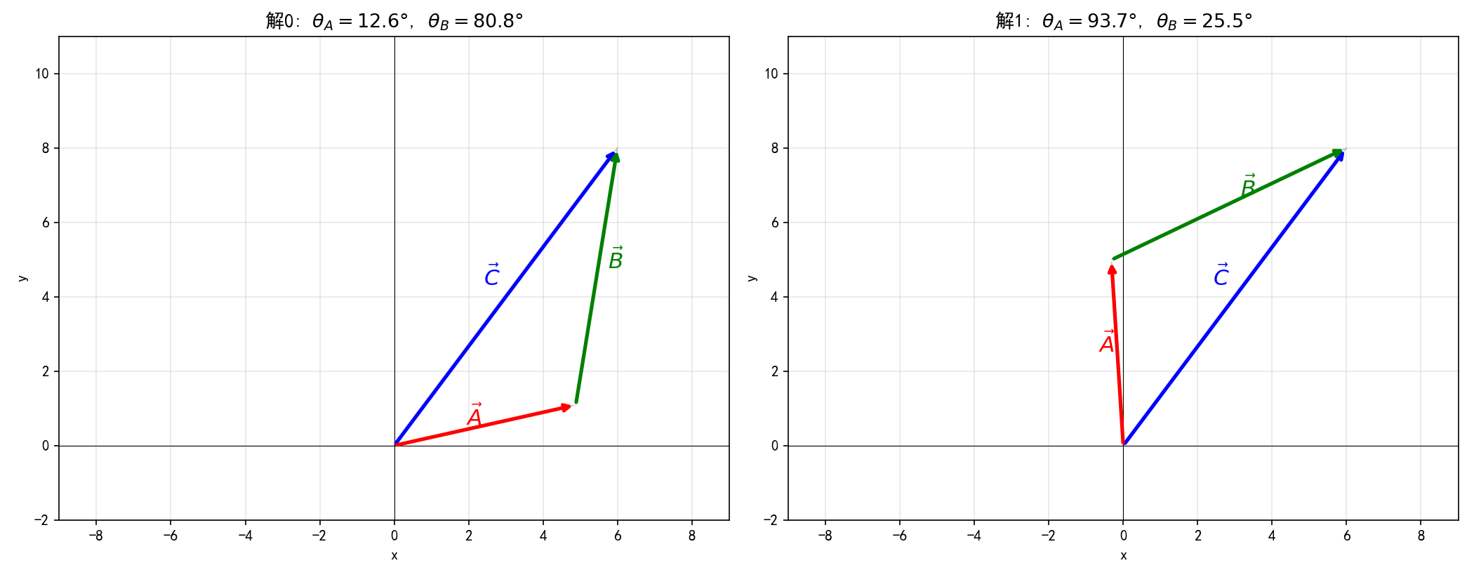
Code_TestCode/向量分解/figures/fig3_two_solutions.png
