Zlxwy/GraduationProject/Code_TestCode/向量分解/figures/fig4_triangle_inequality.png

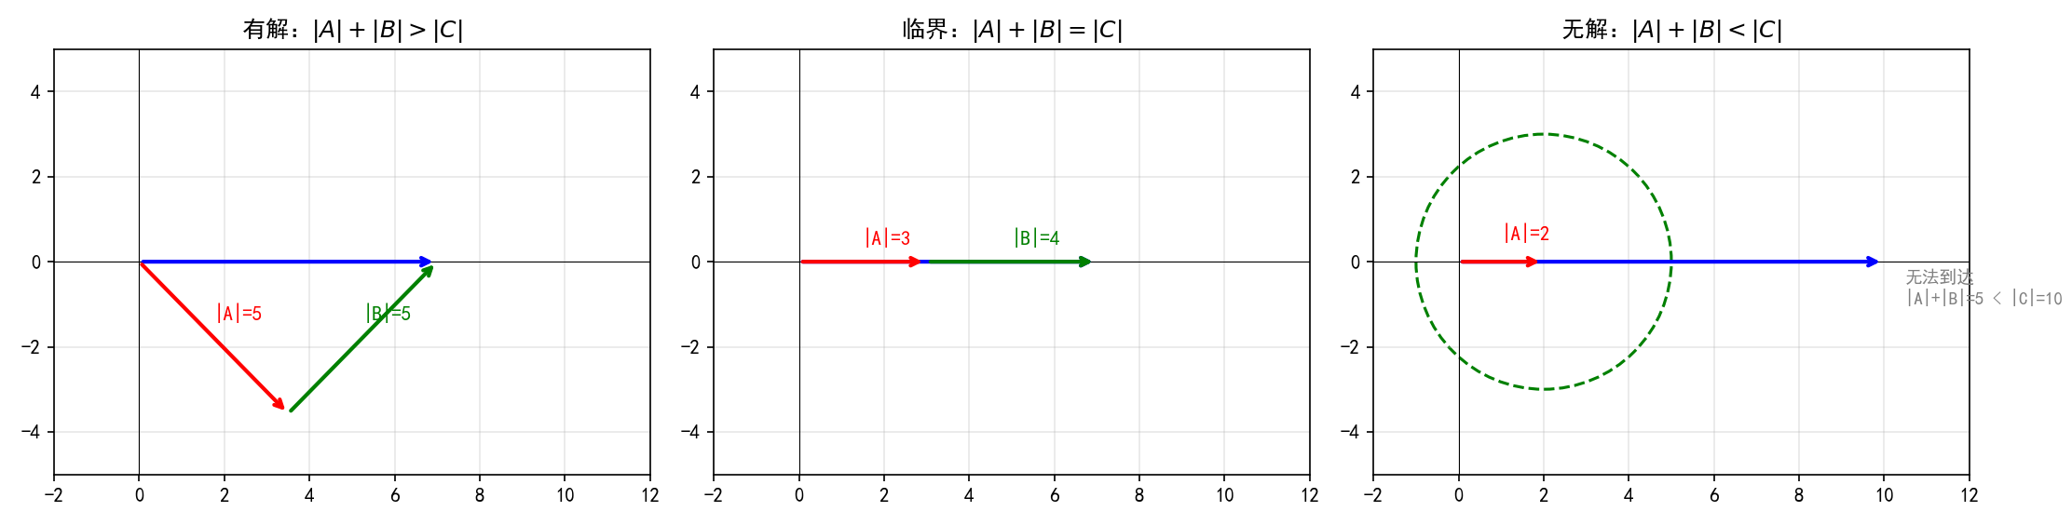
Code_TestCode/向量分解/figures/fig4_triangle_inequality.png
