Zlxwy/GraduationProject/Code_TestCode/向量分解/figures/fig5_linkage_example.png

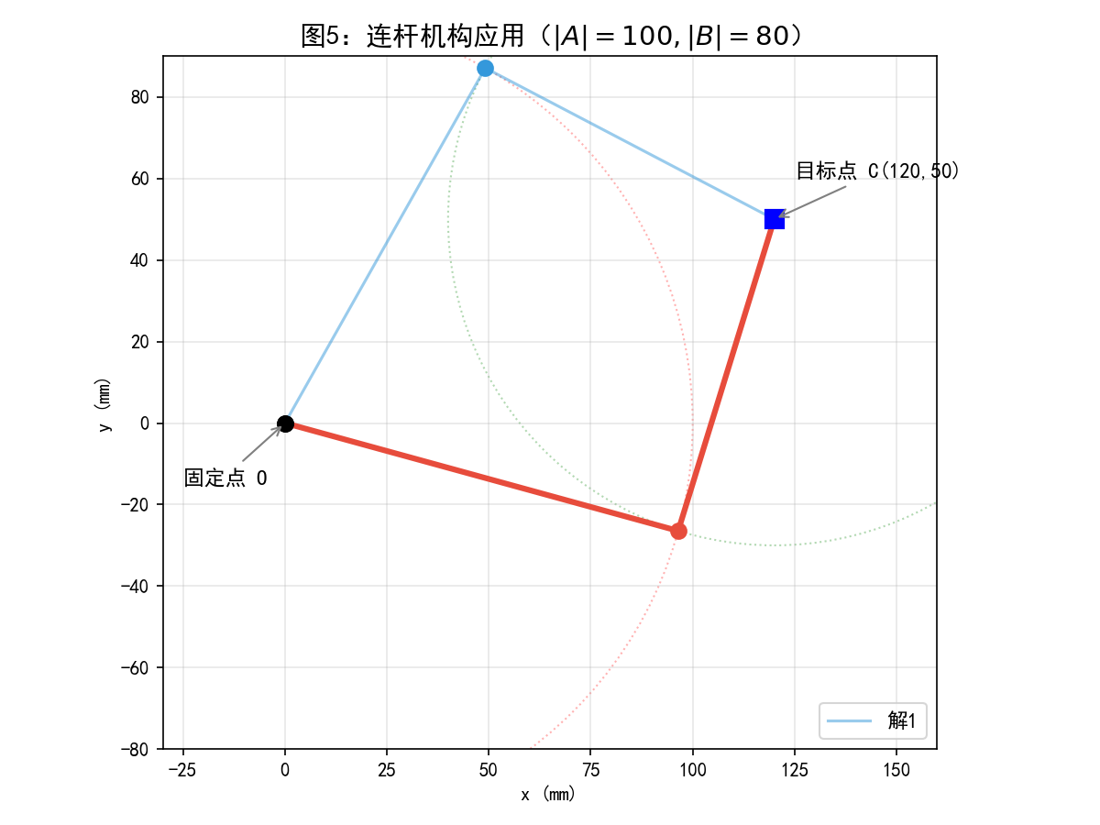
Code_TestCode/向量分解/figures/fig5_linkage_example.png
