Zlxwy/GraduationProject/TODO.md

## 待改进
- [ ] 模型：把磁铁夹持模型的尾巴延长一点，可以做个弧度固定电线。
- [ ] PCB：可以把PCB的电源接口推入一点。
- [ ] PCB：将STM32芯片、三步进电机驱动（用更小的驱动模块）、磁铁驱动、限位器输入等所有电路集成在一块电路板上，以XH2.54提供必要的信号接口，以按键提供用户操作接口
- [ ] 下位机：步进电机的加减速算法优化，或者使用现成的伺服电机驱动套装
- [ ] 上位机：调试完善现实世界的尺寸参数
- [ ] 上位机：画面用超大字体显示对弈结果
- [ ] 上位机：把画面中的提示文字改小一点
- [ ] 上位机：用ROS2重构程序，分为串口队列发送节点、串口扫描接收节点、相机节点、棋子类型识别节点、象棋引擎节点、日志打印节点，可不再受限于单Python全局解释器锁的问题。
- [ ] 论文：论文关闭图像压缩粘贴，重新导入过所有图片。

## 已完成
- [x] 上位机：维护机械臂的位置信息
- [x] 机械臂：绷紧机械臂小臂同步带
- [x] 上位机：数据集采集
- [x] 上位机：数据集训练
- [x] 上位机：测试模型
- [x] 上位机：局势提取
- [x] 上位机：获取棋盘不同
- [x] 上位机：棋子颜色区分
- [x] 上位机：将走法转换为引擎格式
- [x] 上位机：异步调用引擎，非阻塞等待结果
- [x] 上位机：获取引擎结果更新棋盘
- [x] 上位机：两个走棋执行函数：DriveMotor_DropSelfPiece和DriveMotor_EatOppoPiece
- [x] 上位机：为不耗费太多性能，不用一直拍照
- [x] 上位机：标定模式下按1切换标定棋盘或标定机械臂
- [x] 机械臂：解决机械臂撞杆问题
- [x] 上位机：平面坐标系通过单应矩阵进行映射
- [x] 上位机：移植到Linux板卡上看看效果
- [x] 上位机：电脑走法和用户走法的路径箭头分别用灰色和红色
- [x] 下位机：大臂小臂应该能同时运动，计算其同时停止时间设置速度
- [x] 下位机：步进电机驱动缓启停
- [x] 提取透视变换的程序
- [x] 提取象棋识别器的类
