Zlxwy/GraduationProject/PCB_BaseBoard/TODO.md

可以把电源接口往里缩进一点

给步进电机一个单独的电源开关

增多一个12V接口给散热扇，越多越好，目前预计：
1. 步进电机散热扇
2. 步进电机驱动器散热扇
3. 板卡散热扇
4. 补光灯
