Zlxwy/GraduationProject/Code_TestCode/STM32测试程序/Test-SimplePWM/Core/Src/main.c

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
/* Includes ------------------------------------------------------------------*/
#include "main.h"
#include "tim.h"
#include "gpio.h"

/* USER CODE BEGIN Includes */
#include "StepperMotor.h"
/* USER CODE END Includes */


/* USER CODE BEGIN PV */
StepperMotor_t BoomStepperMotor;
/* USER CODE END PV */

void SystemClock_Config(void);
/**
  * @brief  The application entry point.
  * @retval int
  */
int main(void)
{

  /* MCU Configuration--------------------------------------------------------*/

  /* Reset of all peripherals, Initializes the Flash interface and the Systick. */
  HAL_Init();

  /* Configure the system clock */
  SystemClock_Config();

  /* Initialize all configured peripherals */
  MX_GPIO_Init();
  MX_TIM10_Init();
  MX_TIM11_Init();
  MX_TIM13_Init();
  MX_TIM14_Init();
  /* USER CODE BEGIN 2 */
  StepperMotor_Init( // 初始化步进电机
    &BoomStepperMotor, // 大臂步进电机
    &htim10, // 使用定时器10
    TIM_CHANNEL_1, // 使用通道1输出PWM
    168000000, // 内部时钟为168MHz
    14-1, // 进行预分频，14分频，得到168MHz/14=12MHz的CNT计数频率
    4000-1, // 设置自动重装载值为4000，得到12MHz/4000=3kHz的PWM频率
    50, // 高电平占空比50%
    TestDir_GPIO_Port, // 方向引脚端口
    TestDir_Pin, // 方向引脚号
    GPIO_PIN_SET // 高电平为正转
  ); // 在CubeMX配置了PWM引脚为PB8
  HAL_Delay(1000);
  /* USER CODE END 2 */

  /* Infinite loop */
  /* USER CODE BEGIN WHILE */
  // int32_t pulses = 200;
  // uint32_t tone[] = {523, 587, 659, 698, 784, 880, 988, 1047};
  while (1)
  {
    // for (int i=0; i<sizeof(tone)/sizeof(tone[0]); i++) {
    //   StepperMotor_MoveSteps(&BoomStepperMotor, pulses, tone[i]); // Object, steps, speed
    //   while (StepperMotor_GetRunState(&BoomStepperMotor) == StepperMotor_RunState_MoveSteps);
    //   HAL_Delay(500); // 等待1秒
    //   HAL_GPIO_TogglePin(TestLED_GPIO_Port, TestLED_Pin);
    // }
    StepperMotor_MoveSteps(&BoomStepperMotor, 800, 1555); // Object, steps, speed
    while (StepperMotor_GetRunState(&BoomStepperMotor) == StepperMotor_RunState_MoveSteps);
    HAL_Delay(500); // 等待1秒
    StepperMotor_MoveSteps(&BoomStepperMotor, -200, 999); // Object, steps, speed
    while (StepperMotor_GetRunState(&BoomStepperMotor) == StepperMotor_RunState_MoveSteps);
    HAL_Delay(500); // 等待1秒

    StepperMotor_RunContinuous(&BoomStepperMotor, StepperMotor_Direction_Forward, 600); // 以999Hz的频率持续转动，方向为正方向
    HAL_Delay(1000); // 延时1秒
    StepperMotor_Stop(&BoomStepperMotor); // 停止电机
    HAL_Delay(1000); // 延时1秒

    StepperMotor_RunContinuous(&BoomStepperMotor, StepperMotor_Direction_Backward, 999); // 以999Hz的频率持续转动，方向为反方向
    HAL_Delay(1000); // 延时1秒
    StepperMotor_Stop(&BoomStepperMotor); // 停止电机
    HAL_Delay(1000); // 延时1秒
    /* USER CODE END WHILE */

    /* USER CODE BEGIN 3 */
  }
  /* USER CODE END 3 */
}

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
