Zlxwy/GraduationProject/(commit log)

2026-03-30 STM32硬件资源分配
2026-03-30 增加一个LCD的测试工程
2026-03-30 删除STM32总程序的一个配置说明文件
2026-03-30 列举PCB修补项
2026-03-30 增加LCD的FSMC配置
2026-03-30 删除Code_SomeTools下的README
2026-03-30 完成ADC+DMA获取电压的程序，以便后续摇杆驱动
2026-03-30 写两个串口助手，可用于解析串口发送过来的ADC数据
2026-03-30 完善ADCwithDMA的测试例程
2026-03-30 小改步进电机驱动测试的例程
2026-03-30 删除解析电压数据工具的程序，打算重新写个
2026-03-30 去掉SimpleUartHelper中的背景切换按键
2026-03-30 重新写过一个解析摇杆数据的桌面端工具
2026-03-30 增加一些工程说明文档
2026-03-30 编译一下LCD的测试程序
2026-03-30 增加工程说明.txt
2026-03-30 创建一个新的测试工程，UART配合空闲中断和DMA实现不定长数据接收
2026-03-30 CubeMX初次生成
2026-03-31 将串口空闲中断DMA接收功能模块化
2026-03-31 增加注释、使用文档
2026-03-31 更改配置：DMA优先级从低等改为中等
2026-03-31 更改工程名称为Test-UartIdleDmaRx
2026-03-31 修补一个丢帧的问题
2026-03-31 更改工程名称为Test-UartDmaIdleRx
2026-03-31 增加一个Test-UartDmaQueueTx工程
2026-03-31 增加Printf函数
2026-04-02 增加测试工程
2026-04-02 PCB修补
2026-04-03 更改上位机程序的文件夹名称
2026-04-03 对下位机程序进行一次大翻新。 尤其是串口流模块，全部使用了DMA进行发送接收处理； 加入控制电机的消息队列以及线程，定义了部分协议数据结构
2026-04-03 更改README
2026-04-04 更改一处小错误
2026-04-04 删掉一些原有、但已无用处的注释
2026-04-05 更改定时器预分配数值
2026-04-05 PCB更改
2026-04-05 更改下位机代码中的一处互斥锁使用错误
2026-04-08 文档修改
2026-04-08 更改一个文件夹名称
    [results.csv]
2026-04-10 修修改改
2026-04-11 加了一些功能
2026-04-12 开始编写上位机程序
2026-04-12 修改一些格式
2026-04-12 加入LCD的程序
2026-04-23 删上位机程序目录，准备更新
2026-04-23 更新上位机程序 Code_MasterController
2026-04-23 删除下位机程序，准备更新
2026-04-23 更新下位机仓库
2026-04-23 更新测试程序
    [results.csv]
2026-04-23 更改一个目录名称
    [results.csv]
2026-04-23 更改文档
2026-04-23 更新PCB目录
2026-04-23 更改待办文件名，固定格式
2026-04-23 更改视觉识别测试工程内的git忽略对象
2026-04-23 整理坐标透视变换测试案例
2026-04-23 适配一下，到时候放到Linux板卡上运行
2026-04-23 更改测试代码目录里的结构
    [results.csv]
2026-04-23 更改“如何使用WinForms模板”里面的一些表述错误
2026-04-24 更新一个坐标系的文档说明
2026-04-25 初步完成了步进电机的缓启停功能；删除了步进电机驱动脉冲占空比值的设置项并固定为50%
2026-04-25 更换了步进电机缓启停算法，不再丢步
2026-04-25 在下位机缓启停功能完备后，更新上位机程序的平面连杆运动算法，使其能同时达到目标角度
2026-04-25 允许平面的两个步进电机同时运动
2026-04-26 更改旋转角速度为50度每秒
2026-04-29 将MasterCode中的TODO融合到根目录下；将串口号修改为运行输入参数
2026-05-01 增大竖轴下降高度，不然够不到远处棋盘
2026-05-03 上位机程序的README中增加使用说明
2026-05-03 添加个忽略文件夹__pycache__/
2026-05-04 修改上位机README
2026-05-04 更新文档
