Zlxwy/GraduationProject/(notices)

Notices in the files:
Code_TestCode/STM32测试程序/Test-SimplePWM/Core/Src/main.c:
Copyright (c) 2026 STMicroelectronics.
All rights reserved.
This software is licensed under terms that can be found in the LICENSE file
